Forairaaaaa/Ruby-Robot-Dog/README.md

# Ruby1.0

#### 介绍
非常多不合理甚至错误的地方！大家多多指教~

因为课比较多（懒），代码的应用层写的非常的糙，甚至各种骚操作~（当然底层也没好到哪去（狗头））

机械结构都是平面件，但设计得并不太好组装，空间也比较小，维护更是麻烦~~

所以建议参考下就好了~  推荐大家去关注下 灯哥、舵狗王等up主

更多的详情介绍在  "宏电子的激发与控制.pdf"   里, 请原谅我的命名~
