Forairaaaaa/Ruby-Robot-Dog/宏电子的激发与控制.pdf

### 放弃大功率降压模块，分而治之。

每组三只，固定在每条腿总成的龙骨间隙，总线连回总电源管理模块

并联输入，但输出相对独立，不知有无效果
二极管好像无卵用，反而压降0.2v，一定程度限制了负载功率，问题不大 大面积接地，不好焊接

# 舵机电源管理

2020年9月24日 21:15

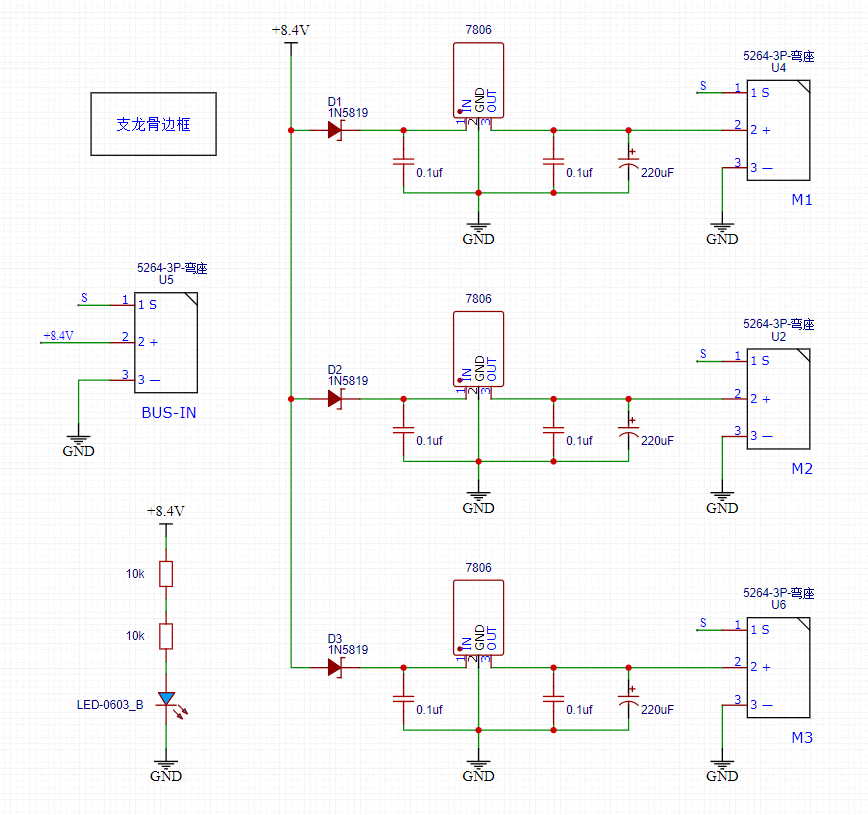
[picture p1: figure]

分区 检测与收集 的第 1 页

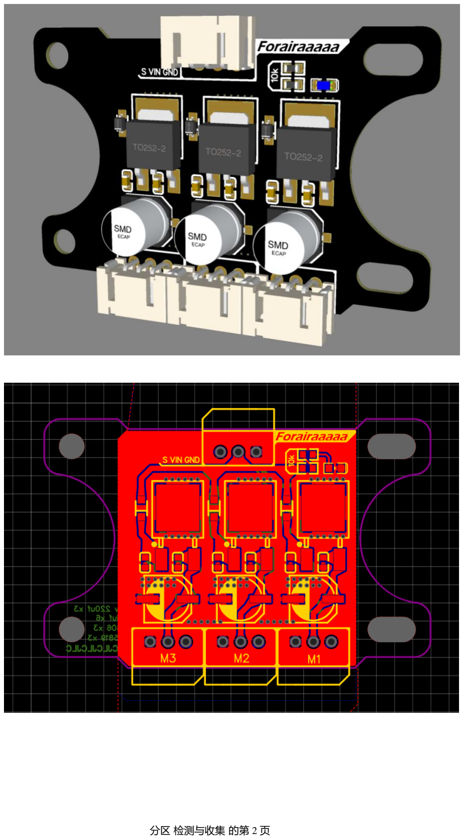
[picture p2: page 2]

分区 检测与收集 的第 2 页

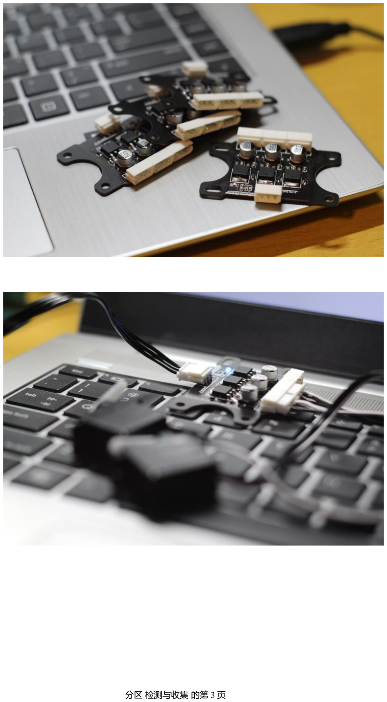
[picture p3: page 3]

分区 检测与收集 的第 3 页

总电源输入，分接舵机电源模块及主板模块

模块只作电源及信号走线，不作任何电压处理（体积限制，淦） 为什么两个开关？ 钱多

# 总电源管理

2020年9月24日 21:45

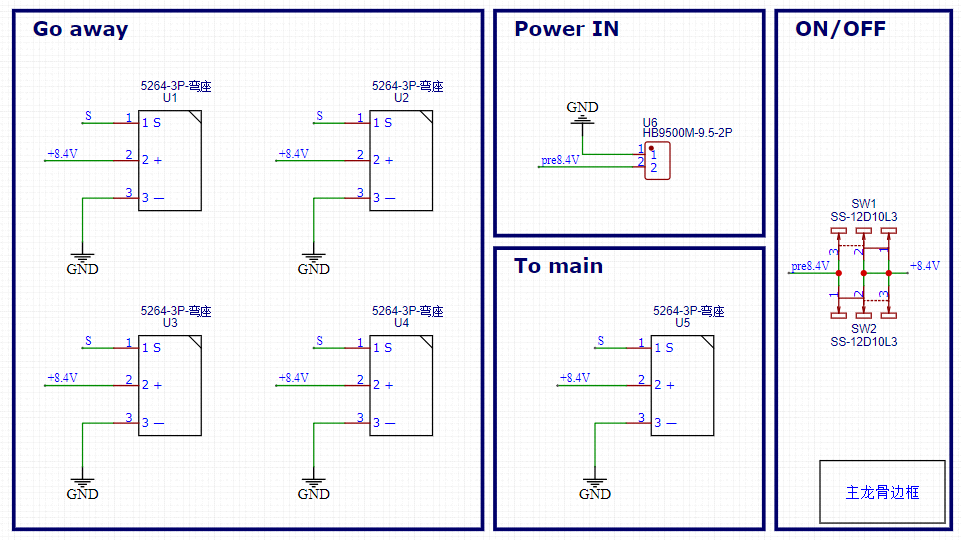
[picture p4: figure]

分区 检测与收集 的第 4 页

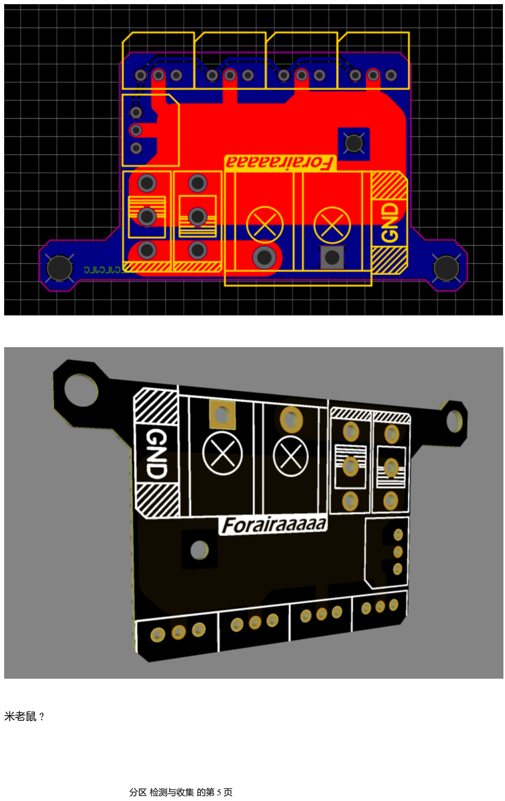
[picture p5: page 5]

米老鼠？

分区 检测与收集 的第 5 页

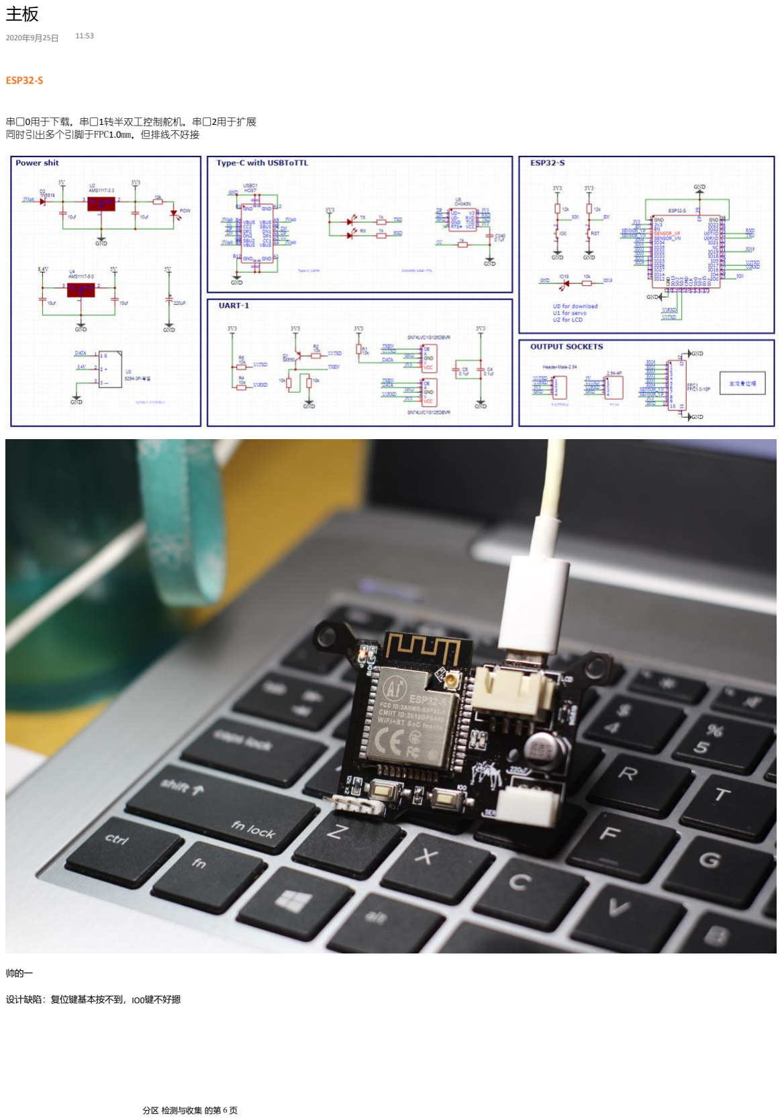
[picture p6: page 6]

ESP32-S

串口0用于下载，串口1转半双工控制舵机，串口2用于扩展 同时引出多个引脚于FPC1.0mm，但排线不好接

帅的一

设计缺陷：复位键基本按不到，IO0键不好摁

主板

2020年9月25日 11:53

分区 检测与收集 的第 6 页

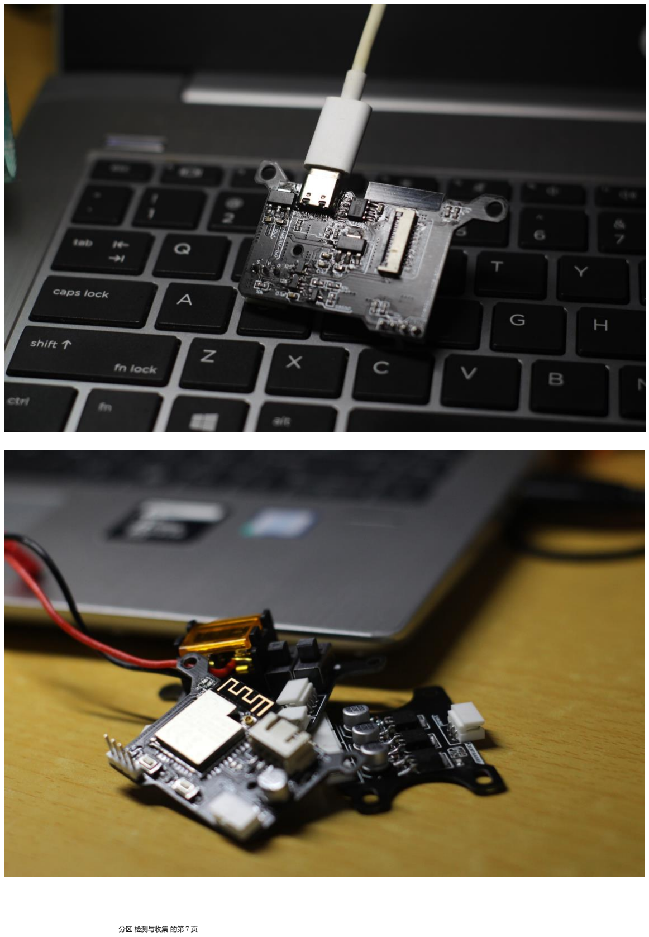
[picture p7: page 7]

分区 检测与收集 的第 7 页

碳纤维太贵了，下次亚克力

并联腿

2020年10月7日 11:30

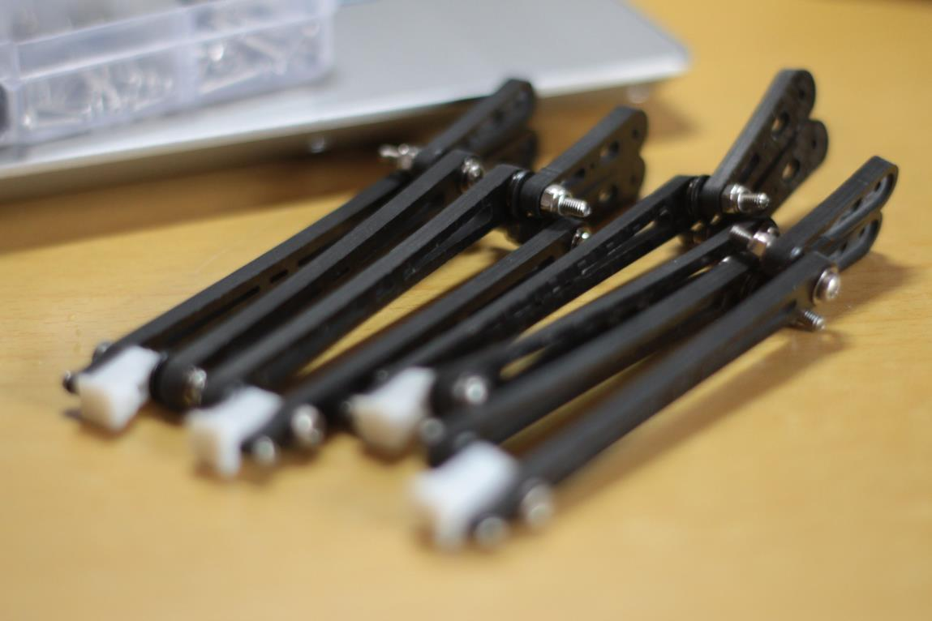
[picture p8: figure]

分区 储存与激发 的第 8 页

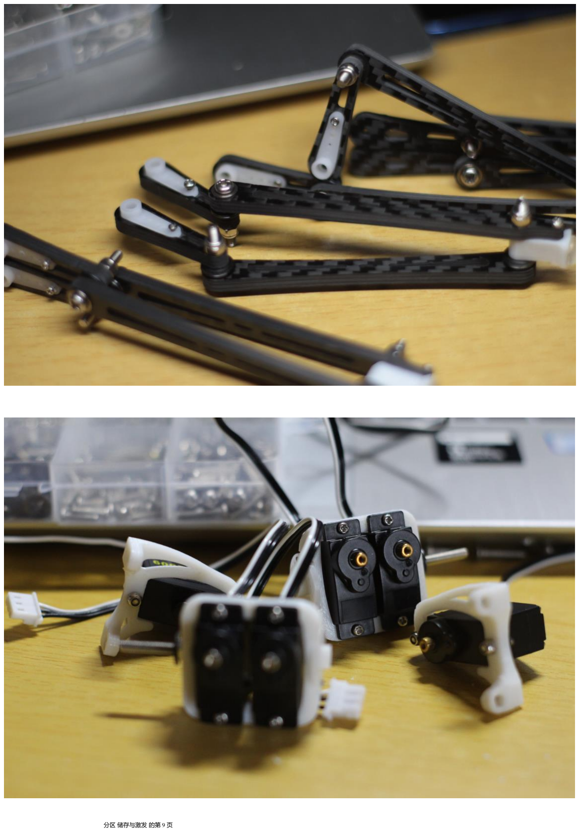
[picture p9: page 9]

分区 储存与激发 的第 9 页

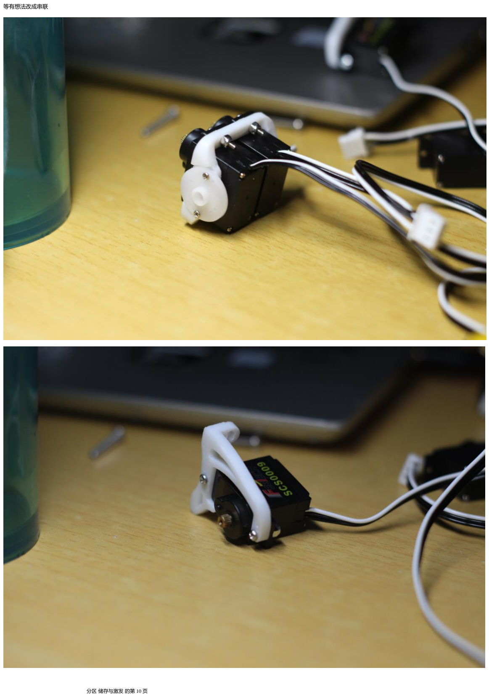
[picture p10: page 10]

等有想法改成串联

分区 储存与激发 的第 10 页

分区 储存与激发 的第 11 页

此机构组装复杂，维护麻烦，精度不好控制，空间小，小学生作品代表~

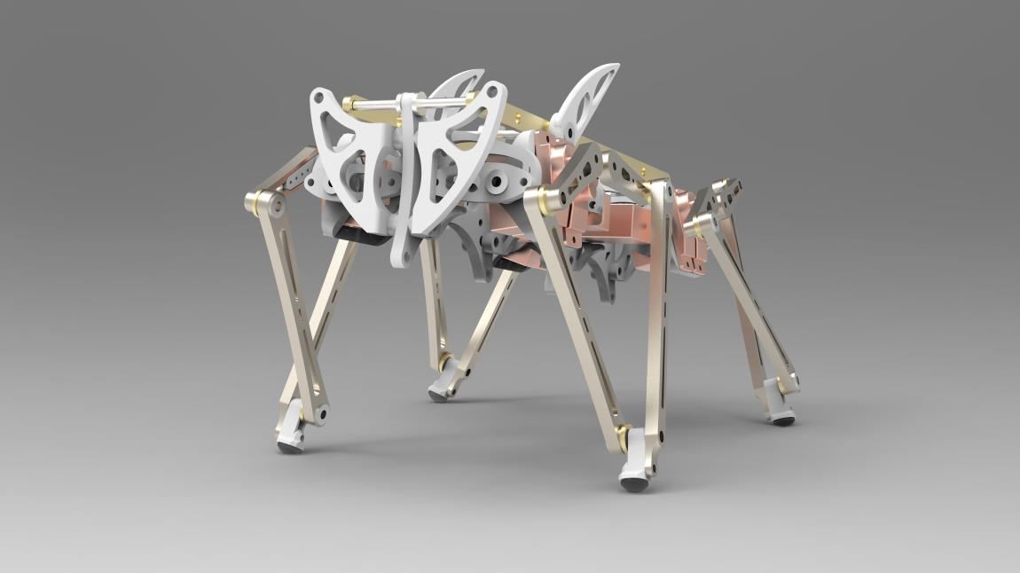
[picture p11: figure]

错综复杂

### 整体机构

2020年10月7日 11:35

分区 储存与激发 的第 12 页

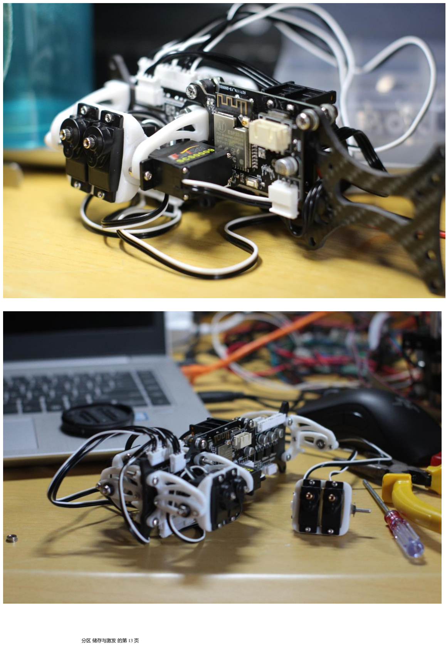
[picture p12: page 13]

分区 储存与激发 的第 13 页

艰难理线

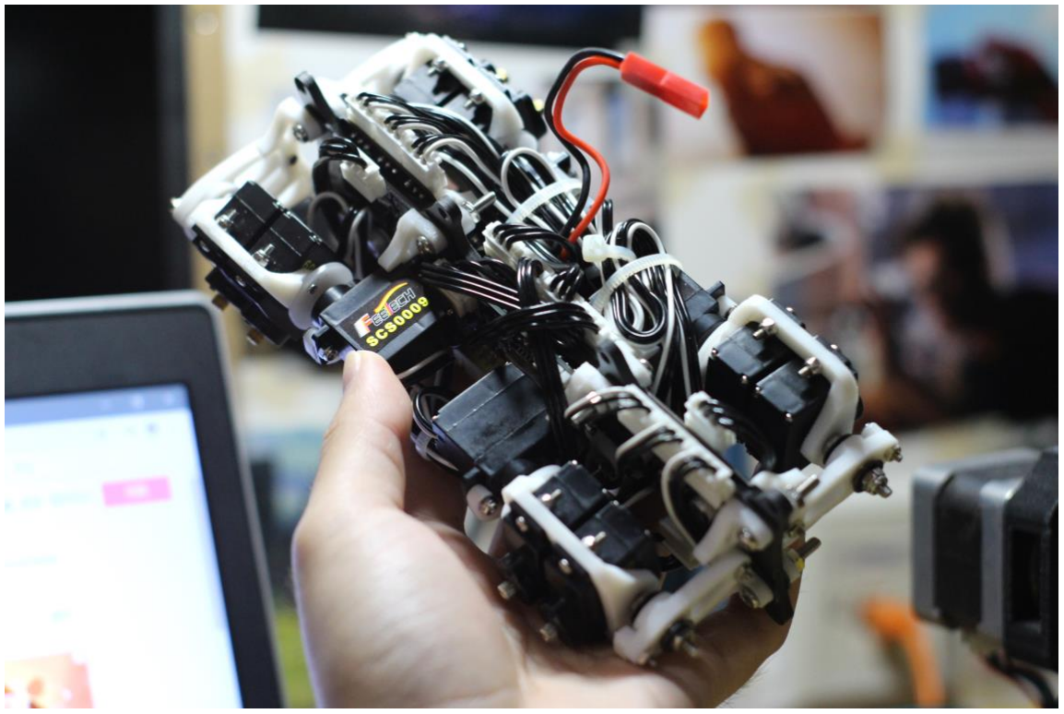
[picture p13: figure]

串口屏

分区 储存与激发 的第 14 页

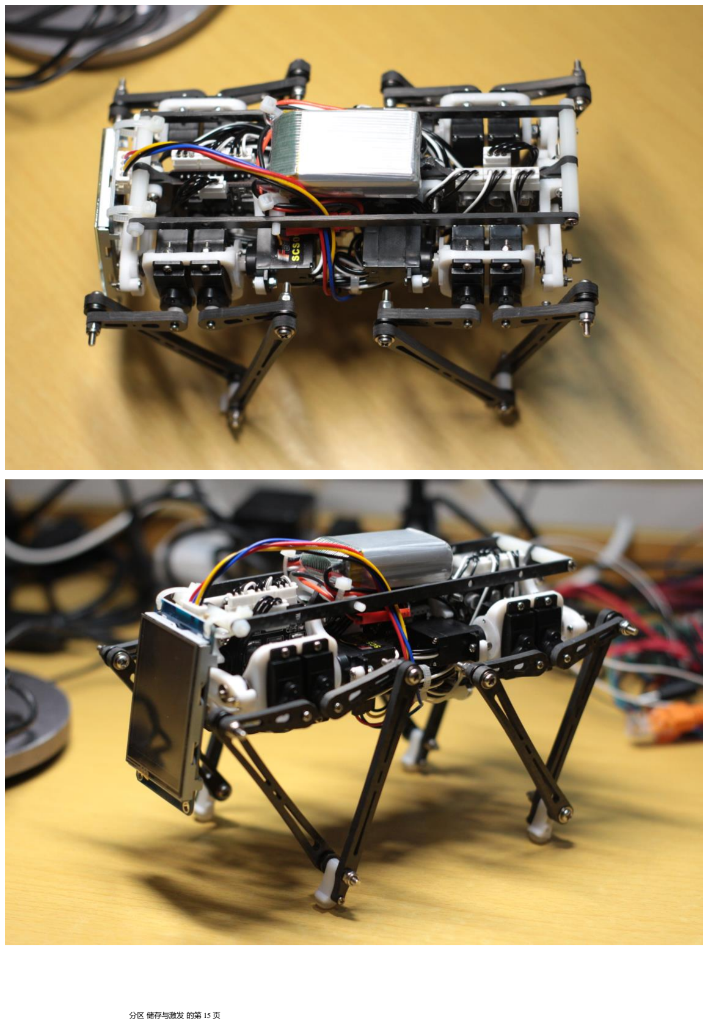
[picture p14: page 15]

分区 储存与激发 的第 15 页

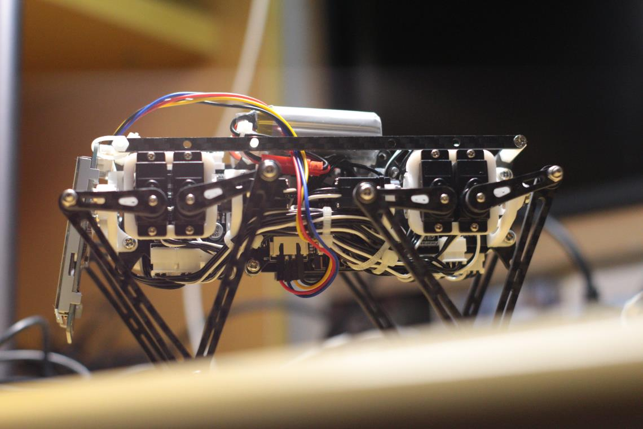
[picture p15: figure]

仍需设计防水挡板等，淦

分区 储存与激发 的第 16 页

主函数提供位姿

程序结构

2020年10月7日 11:43

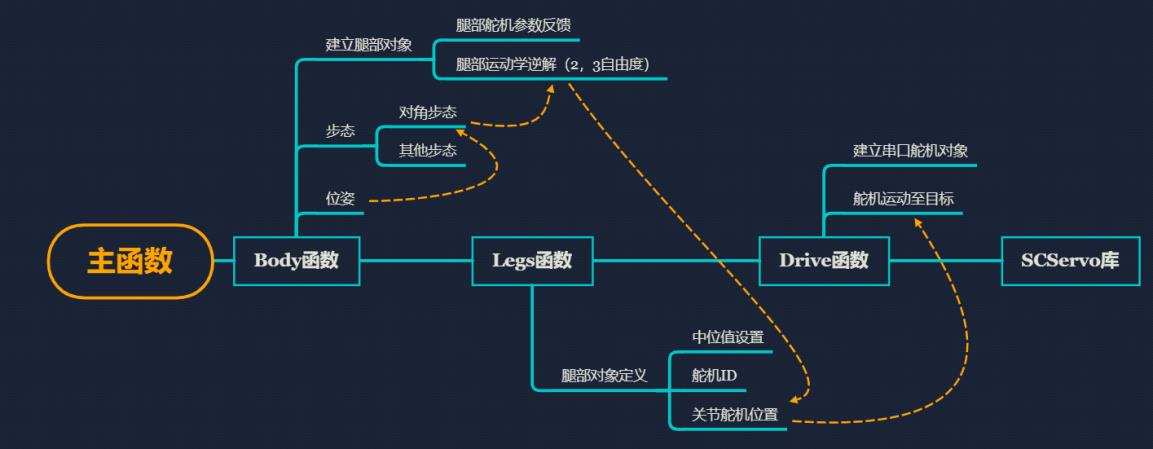
[picture p16: figure]

分区 数学模型 的第 17 页

## 逆解—平面2自由度并联臂

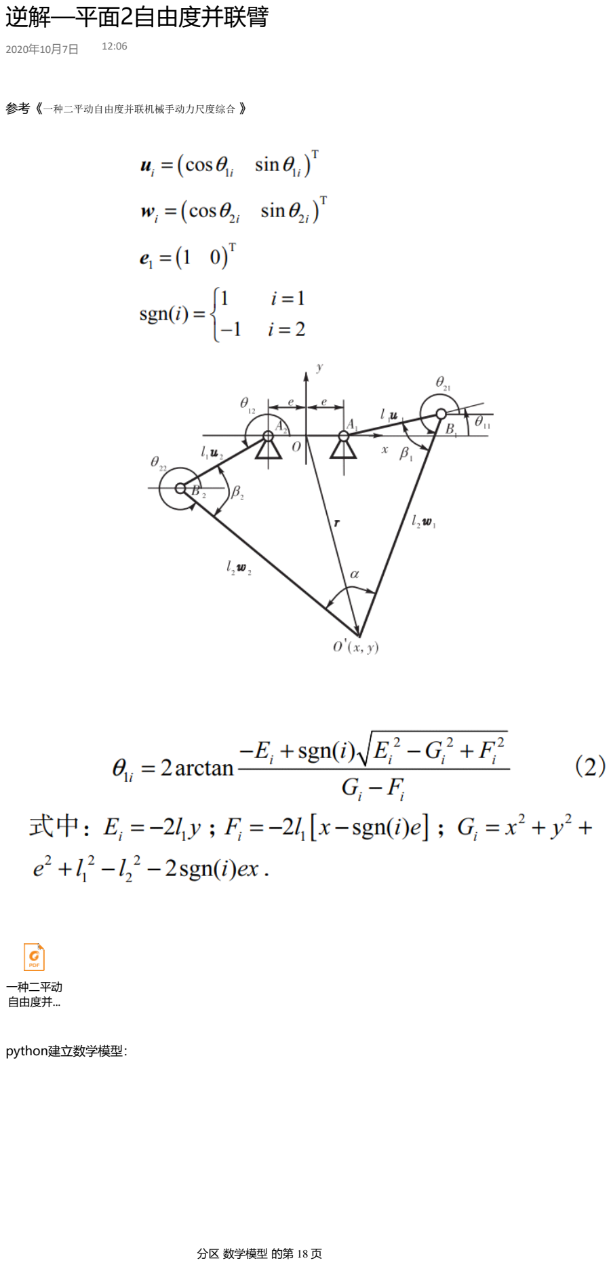
[picture p17: page 18]

参考《一种二平动自由度并联机械手动力尺度综合 》

一种二平动
自由度并...

python建立数学模型：

2020年10月7日 12:06

分区 数学模型 的第 18 页

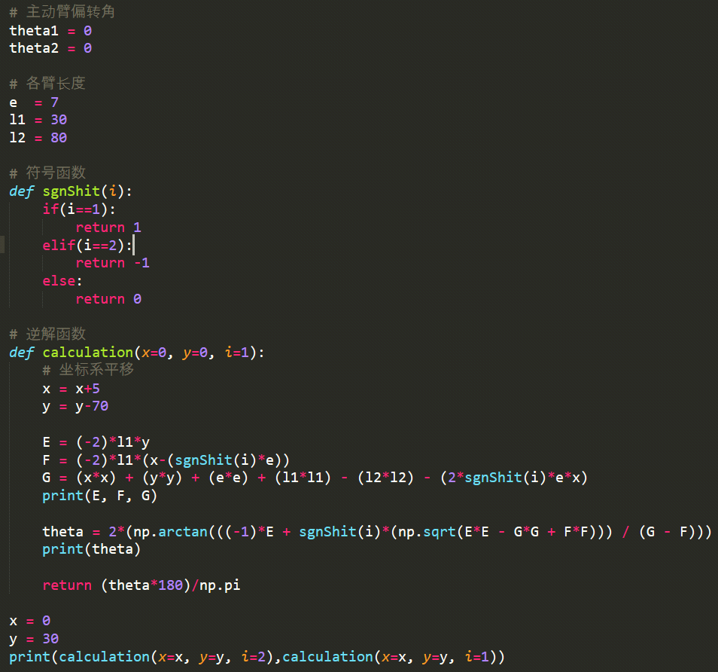
[picture p18: figure]

并联平面
2自由逆解

分区 数学模型 的第 19 页

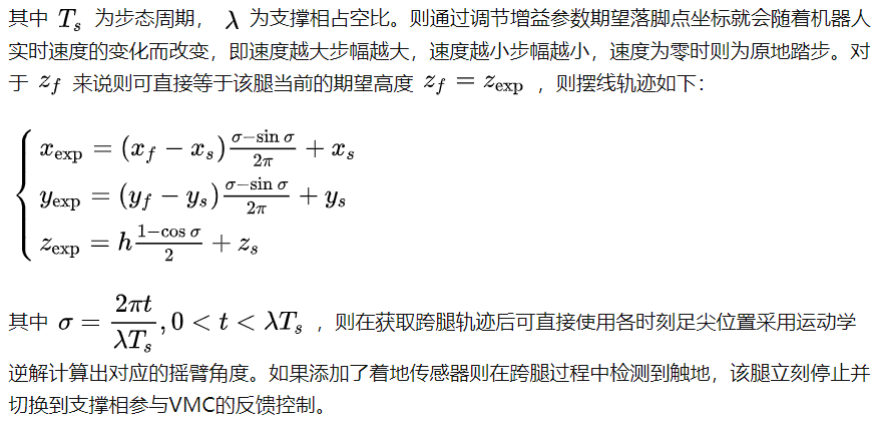
[picture p19: figure]

python数学模型：

参考：https://zhuanlan.zhihu.com/p/69869440

# 8自由度足端轨迹规划

2020年10月7日 12:11

分区 数学模型 的第 20 页

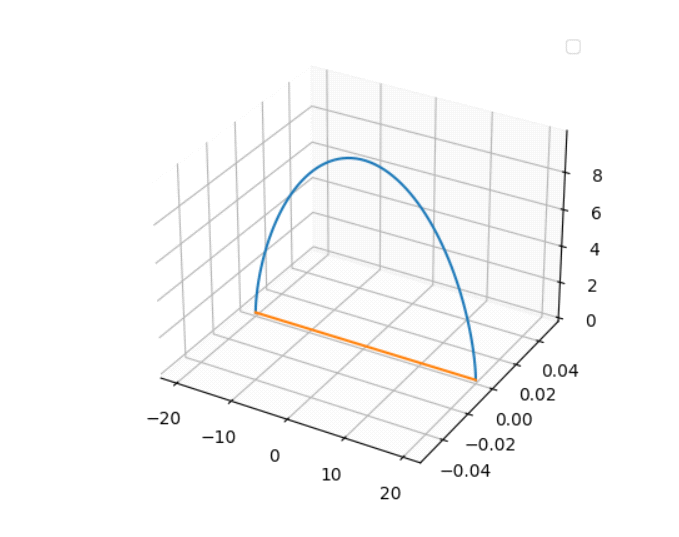
[picture p20: figure]

摆线方程测
试

分区 数学模型 的第 21 页

应该不错的步态设置：

# 8DOF应用层

2020年10月12日 20:30

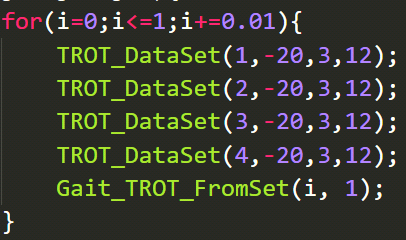
[picture p21: figure]

分区 数学模型 的第 22 页

波特率：

AT+BAUD=7 | // 115200

上位机端：

AT+RXA=0x01,0x02,0x03,0x04,0x05 | // 接收地址
AT+TXA=0x01,0x02,0x03,0x04,0x06 | // 发送地址

接收机端：

AT+RXA=0x01,0x02,0x03,0x04,0x06 | // 接收地址
AT+TXA=0x01,0x02,0x03,0x04,0x05 | // 发送地址

# 无线串口

2020年10月13日 19:10

分区 数学模型 的第 23 页
