Forairaaaaa/Ruby-Robot-Dog/机械/总体组装.stp

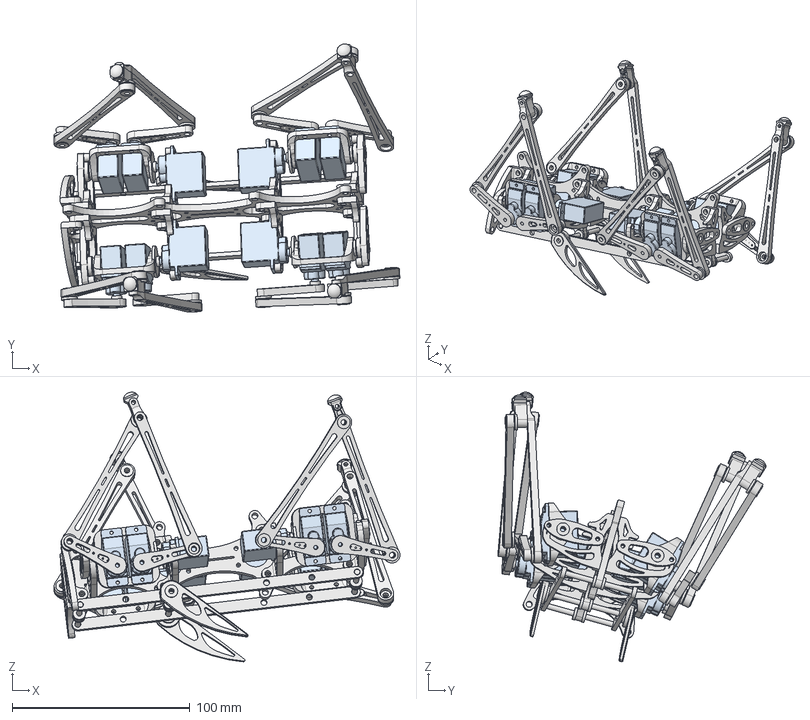
[picture p22: CAD file, 2020-10-19]
机械/总体组装.stp
194.8 x 151.0 x 151.8 mm
scs009 x 12
scs009舵臂 x 8
Sbi 短臂 x 8
桥臂联 x 4
LA 长臂A x 4
LB2 长臂B x 4
梅花垫圈 x 18
M3 法兰 3x6x2.5 x 32
舵机架 x 4
scs009舵盘 x 4
8mm缓冲垫 x 4
大臂舵机架 x 4
大臂轴承架 x 4
大臂舵机架_1 x 4
支龙骨
长载荷架 x 2
M3 长螺杆 x 3
耳
耳_1
大臂舵机架_2
大臂舵机架_3
