Forairaaaaa/Ruby-Robot-Dog/(commit log)

2020-10-19 新建 电控
2020-10-19 设计软件：立创eda
2020-10-19 新建 程序
2020-10-19 删除文件 电控
2020-10-19 删除文件 程序
2020-10-19 mt first commit
    [总体组装.stp]
2020-10-19 电控，机械，程序的进一步描述（我才不会说其实是日记直接导出的呢~（狗头））
